piegolf/magpie/Mods/magpie-mod-z-axis/CAD/motor_spacer_25mm.step

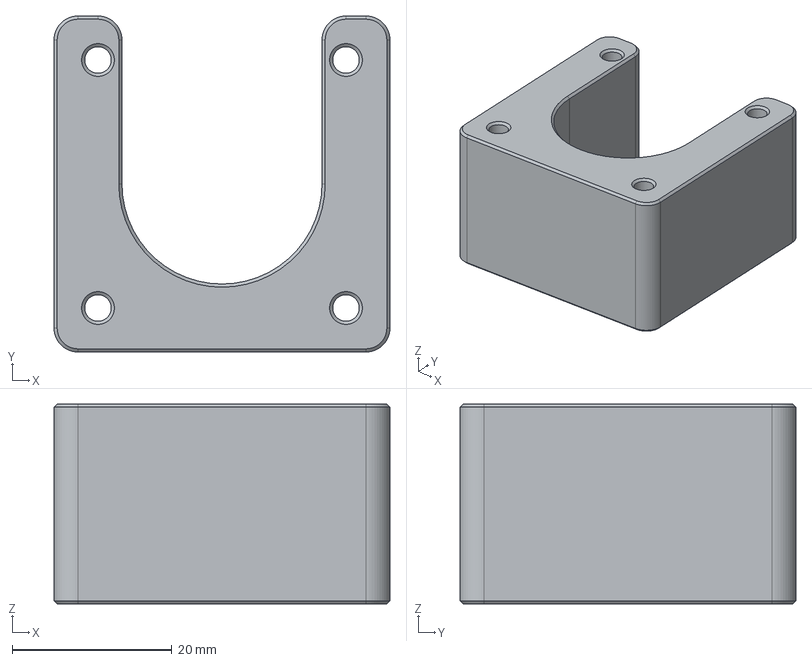
[picture p9: CAD file, 2026-10-02]
Mods/magpie-mod-z-axis/CAD/motor_spacer_25mm.step
42.0 x 42.0 x 25.0 mm
