piegolf/magpie/Mods/magpie-mod-z-axis/STL/zcorner_L.stl

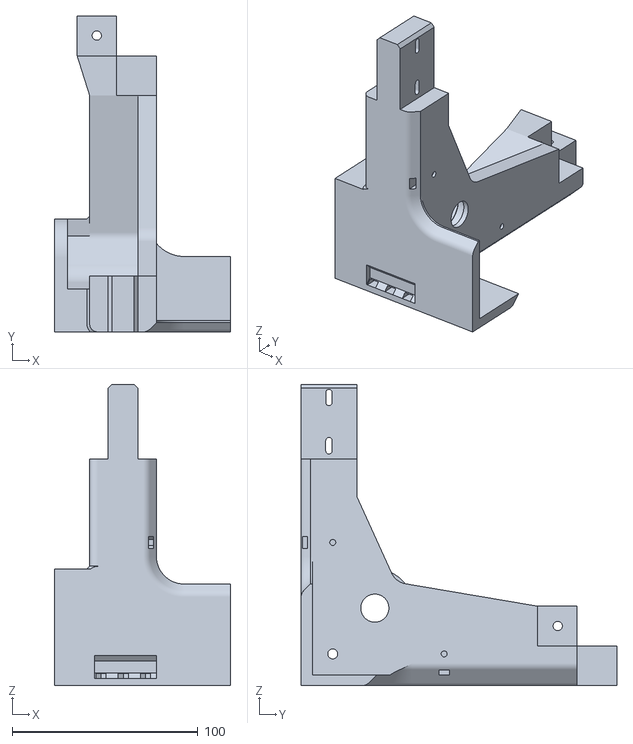
[picture p10: CAD file, 2026-10-02]
Mods/magpie-mod-z-axis/STL/zcorner_L.stl
95.0 x 170.0 x 162.1
