piegolf/magpie/Mods/magpie-mod-z-axis/STL/2x_spacer_top.stl

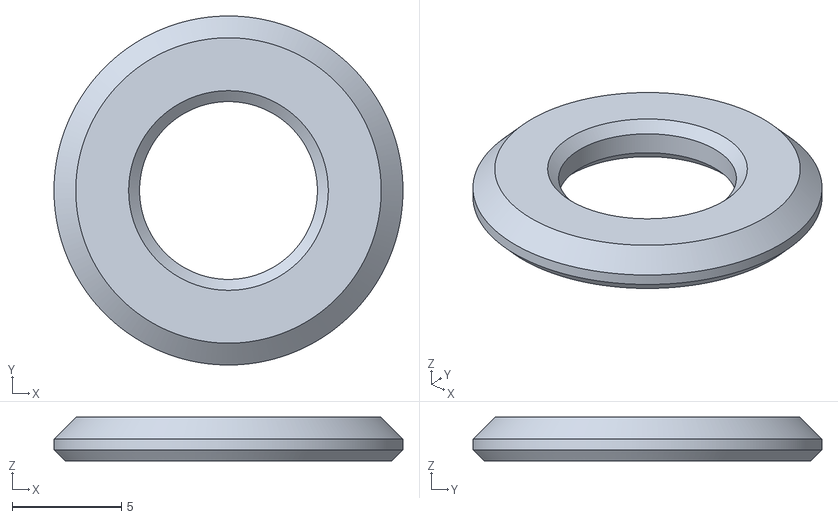
[picture p11: CAD file, 2026-10-02]
Mods/magpie-mod-z-axis/STL/2x_spacer_top.stl
16.0 x 16.0 x 2.00
