piegolf/magpie/Mods/magpie-mod-z-axis/CAD/Z-axis_mod-Coupling_box.step

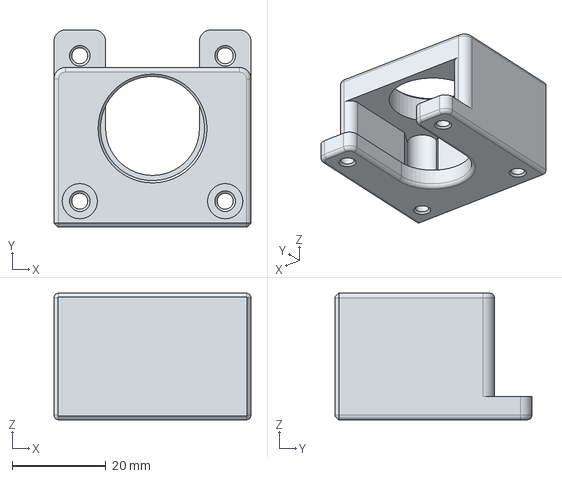
[picture p12: CAD file, 2026-10-02]
Mods/magpie-mod-z-axis/CAD/Z-axis_mod-Coupling_box.step
42.0 x 42.0 x 27.0 mm
