piegolf/magpie/Mods/magpie-mod-z-axis/STL/2x_spacer_bottom.stl

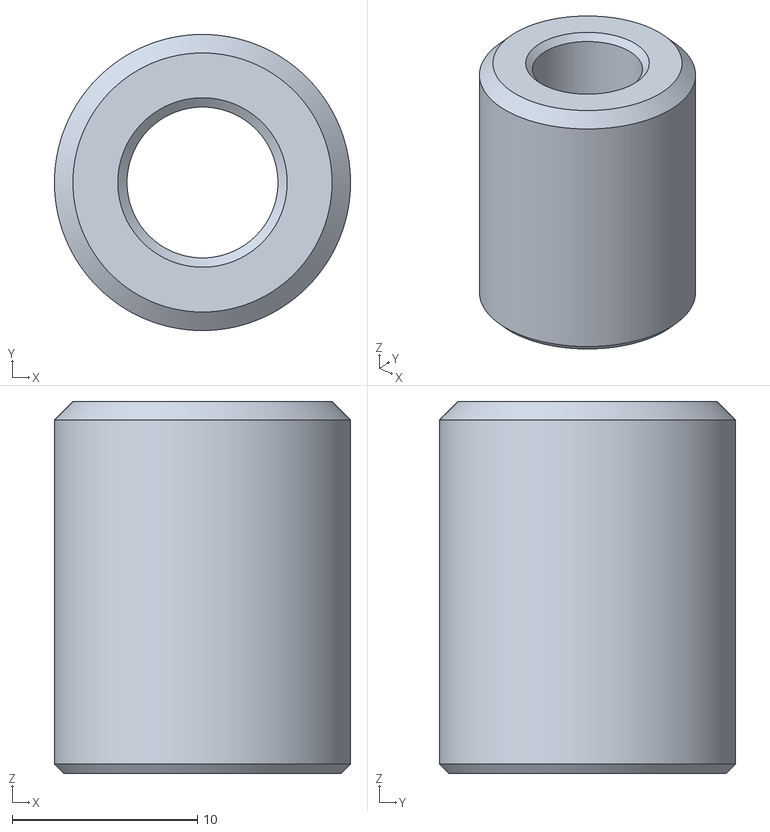
[picture p13: CAD file, 2026-10-02]
Mods/magpie-mod-z-axis/STL/2x_spacer_bottom.stl
16.0 x 16.0 x 20.1
