piegolf/magpie/Mods/magpie-mod-z-axis/CAD/zcorner.step

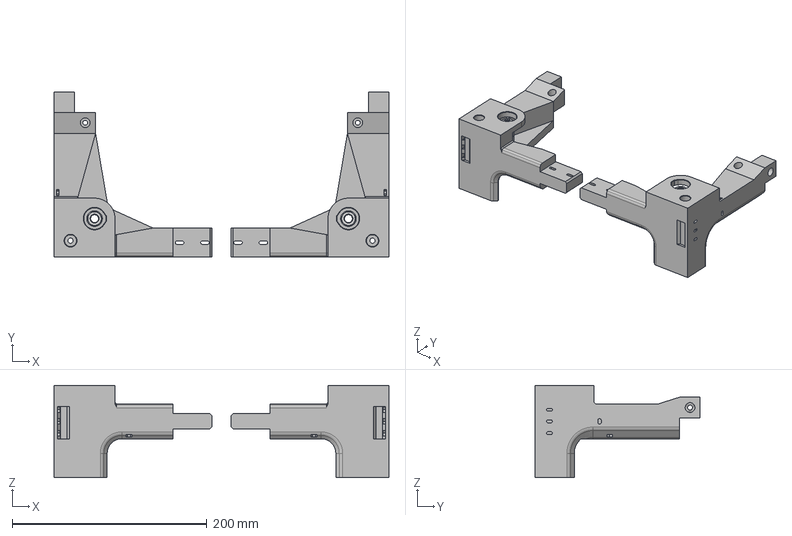
[picture p14: CAD file, 2026-10-02]
Mods/magpie-mod-z-axis/CAD/zcorner.step
344.1 x 170.0 x 95.0 mm
bottom_front_left_frame
GT2 20T Pulley 8mm v2_002 x 2
spacer bottom x 2
spacer top x 2
bottom_front_left_frame_1
