piegolf/magpie/(list of files, cad)

Other CAD files:
forked-cad/Magpie_Rev_1.1.step
Mods/magpie-mod-z-axis/CAD/25mm motor spacer.FCStd
Mods/magpie-mod-z-axis/STL/zcorner_R.stl
Mods/magpie-mod-z-axis/STL/Z-axis_mod-Coupling_box.stl
Mods/magpie-mod-z-axis/STL/motor_spacer_25mm.stl
forked-cad/Magpie_Rev_1.1.f3d
