piegolf/magpie/(commit log)

2025-05-21 first revision
    - made a rough BOM
    - cleaned up CAD
    - modified all parts to not use 14mm and 50mm long screws as they're uncommon sizes
    - modified x carriage to use 3 bearings instead of 2
    - reinforced bambu hotend mount
    - designed alt z carriage and sherpa mini mount
    [BOM.ods, Magpie_Rev_1.1.f3d, Magpie_Rev_1.1.step, Magpie_Rev_1.step]
2026-10-02 added forked cad
    [Magpie_Rev_1.1.f3d, Magpie_Rev_1.1.step]
2026-10-02 added my z axis mod
    [25mm motor spacer.FCStd, 2x_spacer_bottom.stl, 2x_spacer_top.stl, Z-axis_mod-Coupling_box.step, Z-axis_mod-Coupling_box.stl, motor_spacer_25mm.step, motor_spacer_25mm.stl, zcorner.step]
